sinara-hw/Clocker/README.md

# Clocker
Clock buffer with SMA &amp; MMCX input and 4 SMA &amp; 6 MMCX outputs

## Design Files

Design files (schematics, PCB layouts, BOMs) can be found at [Clocker/Releases](https://github.com/sinara-hw/Clocker/releases).

## Wiki

More information can be found on the [wiki](https://github.com/sinara-hw/Clocker/wiki).
