sinara-hw/Clocker/(list of files, drawings)

Other design files:
Clocker.PrjPcb
Clocker.SchDoc
