sinara-hw/Clocker/(threads)

Thread 1 (2018-06-13):

Clocker: fix grounding

marmeladapk, 2018-06-13:
_From @hartytp on [2018-03-28 23:31](https://github.com/sinara-hw/sinara/issues/537)_

same as Kasli https://github.com/sinara-hw/sinara/issues/499#issuecomment-377071799

hartytp, 2020-05-25:
Really, we should just use a flux-cored balun for the output isolation like in other designs. 1GHz should still be enough bandwidth to transmit a decent square wave output

gkasprow, 2020-05-25:
Good idea. What about TC2-72T+  50 Ohms 10 to 700 MHz RF Transformer ?

hartytp, 2020-05-25:
That seems to be about the fastest that MCL do, so yeah sounds about right...

As this is a major change, it's worth giving other stakeholders (@jordens) a chance to comment before deciding

dnadlinger, 2020-05-25:
Mostly to satisfy my own curiosity: Why go back on the earlier design choice now?

I didn't check how the TC2-72T+ compares to the current choice in terms of insertion loss/bandwidth, but one thing to consider would be to keep enough slew rate to be able to cascade Clockers with little phase noise degradation even with moderate coax losses in between (the ADCLK950 performance starts to degrade below 4 V/ns).

jordens, 2020-05-25:
This would kill (or at least risk) 1 GHz direct drive Urukul applications. Nobody felt the need to populate the balun (transmission line or not) there either. Is there data that says the transmission line transformers are a problem? And do we know that the loss in bandwidth does not represent one?
I don't see the benefit.
#4 would be very helpful here.

hartytp, 2020-05-25:
> Nobody felt the need to populate the balun (transmission line or not) there either.

I don't follow your point here. In the current release of clocker there are TCM2-43X+ baluns on all inputs and outputs.

hartytp, 2020-05-25:
> Is there data that says the transmission line transformers are a problem?

It's very situation dependent but, yes, I've certainly seen cases where measured clock phase noise was significantly higher than expected from data sheets and where the resolution was to add an RF isolation transformer.

@dnadlinger whether that's more of an issue than the decrease in bandwidth in a particular situation is hard to tell without measurements, but I have definitely seen cases where it was. And, given that one of our major use-cases for clocker is sending our time base between labs, I wouldn't be confident saying that it's not an issue without checking.

Running the numbers crudely, if we want `2*pi*f*A=4V/ns` then at 700MHz we need 650mV signal amplitude in the differential signal. The clock buffer puts out 800mV amplitude (again differential), so I agree that we don't have a huge amount of headroom once the various losses are included and we will likely not achieve the IC's specified noise floor with a slower balun. Having said that, I doubt we're achieving it now due to ground loops etc, so it's hard to know whether it would get better or worse.

> This would kill (or at least risk) 1 GHz direct drive Urukul applications.

That's not a use case I've considered. But, yes, if people are actually using clocker at 1GHz then this balun is likely not appropriate.

Anyway, I don't feel too strongly about this other than that we should not be using capacitors for isolation.

gkasprow, 2020-05-25:
What we can do is to make isolation transformer variant default. The output baluns were used only to ramp up the amplitude twice and to have the same rise and fall time. The xECL output stage can only source current. Balun makes the output fully symmetrical. What we can do is to have two assembly variants - one, direct output without a balun, with twice lower amplitude but higher BW (comparing with a balun). Second variant would be with fully isolating transformers, higher amplitude but 700MHz BW

hartytp, 2020-05-25:
If people are worried about slew rates then we should keep the TLT as a variant.

gkasprow, 2020-05-25:
Both balun and transformer have compatible footprints. We can make a variant and populate one or another.

gkasprow, 2020-05-25:
That's not that easy. The footprints are compatible but rotated. I would need to add two more 0R resistors to the assembly variant. I'm not sure if it is worth the effort. I think it's too complex
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

hartytp, 2020-05-25:
Sure, let's just unfloat the grounds and leave it as is then.

gkasprow, 2020-05-25:
@hartytp before, default configuration was 100k biasing resistor and AC-coupling.
Shall I change this? TS plans to produce a large batch of these boards.

jordens, 2020-05-26:
> > Nobody felt the need to populate the balun (transmission line or not) there either.
>
> I don't follow your point here. In the current release of clocker there are TCM2-43X+ baluns on all inputs and outputs.

'There' meaning urukul.

jordens, 2020-05-26:
> It's very situation dependent but, yes, I've certainly seen cases where measured clock phase noise was significantly higher than expected from data sheets and where the resolution was to add an RF isolation transformer.

I'm sure that it can be a problem. And in that situation you do need to sacrifice bandwidth to isolation. I'd add an external dedicated balun there.

gkasprow, 2020-05-26:
so what's the conclusion. DO you want 100k or 0R resistor between GND and SMA ?

jordens, 2020-05-26:
0R in my opinion. We don't do differentially floating sma like that anymore AFAICT. It made things worse on urukul in the cases I looked at. And it is dangerous/extremely annoying/unhelpful w.r.t. ground voltage differentials.

gkasprow, 2020-05-26:
OK, so let's close this issue

dtcallcock, 2020-05-28:
>0R in my opinion. We don't do differentially floating sma like that anymore AFAICT. It made things worse on urukul in the cases I looked at.

The discussion in the wiki should probably be re-written to reflect this new school of thought.

Closed 2020-05-26.

Thread 2 (2018-06-13):

Clocker v1 errata and tests

marmeladapk, 2018-06-13:
_From @gkasprow on [2017-12-12 11:01](https://github.com/sinara-hw/sinara/issues/421)_

Clocker v1 arrived.
There are some minor issues:
- [x] Use the 712RA barrel connector (not the long barrel L712RA). Same footprint. Just shorter barrel.
- [x] voltage setting resistor should be 33k instead of 3.3k
- [x] front panel SMA assignment is wrong - clock input is on bottom, not top. It was in initial project and changes were not transferred to the panel design.
- [x] insulating washers are bigger than in documentation. The SMA port description must be shifted away by 1mm
- [x] SMA connector mechanical models are different than actual connectors. Actual ones do not have a ring around the SMA thread. So I had to install a washer to give a support for insulating washer
- [x] move new supply connector 0.75mm towards the panel
- [x] add insulating washers to BOM
- [x] consider adding an LC filter or ferrite bead between the SMPS and LDO. Maybe add a tantalum cap to damp any LC ringing? Use same inductor that is already used on the SMPS in combination with a large tantalum cap.
- [x] Populate MMCX input.
- [x] Silk + schematic + panel should be "v1.x" not "rev1.x"
- [x] add divider on PGFB pin

Otherwise it works fine.
Today I will ship it to @hartytp

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

marmeladapk, 2018-06-13:
_From @hartytp on [2017-12-12 14:33](https://github.com/sinara-hw/sinara/issues/421#issuecomment-351068322)_

Great, thanks!

marmeladapk, 2018-06-13:
_From @jbqubit on [2017-12-12 14:59](https://github.com/sinara-hw/sinara/issues/421#issuecomment-351076149)_

Looks great!

marmeladapk, 2018-06-13:
_From @hartytp on [2018-02-01 14:15](https://github.com/sinara-hw/sinara/issues/421#issuecomment-362277991)_

Had a look at clocker today. The error on the FP threw me for a while other than that, it looks good...

Source for all measurements is a Wenzel 100MHz oscillator (+13dBm) driving clocker directly via the FP SMA.

marmeladapk, 2018-06-13:
_From @hartytp on [2018-02-01 14:20](https://github.com/sinara-hw/sinara/issues/421#issuecomment-362279369)_

Rise time is something like a few hundred ps ignoring the reflections. The ADCLK itself should provide more like 100ps, but once the balun and the scope BW (4GHz) are taken into account, this is roughly what one expects.

Pk to pk signal is about 800mV. Expect 16.Vpp out of the ADCLK, that's 1.1Vpp into 50R, and 900mV once the 2dB (ish) balun loss at 100MHz is taken into account.

SI looks generally good on the scope. So this all checks out...
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

marmeladapk, 2018-06-13:
_From @hartytp on [2018-02-01 14:26](https://github.com/sinara-hw/sinara/issues/421#issuecomment-362281326)_

Phase noise looks excellent (plots to follow later).
- noise floor at about -145dBc/Hz
  - NB this is not expected to follow the 20*log(f) scaling with the frequency of the carrier.
  - limit to white noise is probably the fact that I'm doing this at 10MHz. dV/dt is: 2xpixAxf= 2xpix(sqrt(2)x1.4V)x100MHz=1V/ns. Looking at figure 12 of the datasheet, we're definitely still in the regime where the jitter is limited by the input slew rate, so this makes sense.

marmeladapk, 2018-06-13:
_From @hartytp on [2018-02-01 14:27](https://github.com/sinara-hw/sinara/issues/421#issuecomment-362281663)_

I did see a few spurs, particularly on the AM spectrum, which look like they come from the SMPS. Probably worth adding an LC filter (or ferrite) between the SMPS and LDO. If we do that, make sure to add a tantalum cap or something to prevent ringing in the LC filter.

marmeladapk, 2018-06-13:
_From @hartytp on [2018-02-01 14:28](https://github.com/sinara-hw/sinara/issues/421#issuecomment-362282053)_

Anyway, great work @gkasprow on another design that worked more or less perfectly on the first attempt! It's a very low priority compared with Sayma/Booster, but at some point I'd like to order some more of these with the bug fixes applied.

marmeladapk, 2018-06-13:
_From @gkasprow on [2018-02-01 14:53](https://github.com/sinara-hw/sinara/issues/421#issuecomment-362289359)_

I have a few pieces still in my lab. I will test them in a few days.

marmeladapk, 2018-06-13:
_From @hartytp on [2018-02-01 15:08](https://github.com/sinara-hw/sinara/issues/421#issuecomment-362293989)_

@gkasprow There are no more tests that I want to see done; as far as I'm concerned this board works and nothing else is needed.

I'd prefer to buy v1.1 boards with the fixes applied (e.g. a new front panel!).

marmeladapk, 2018-06-13:
_From @gkasprow on [2018-02-01 15:14](https://github.com/sinara-hw/sinara/issues/421#issuecomment-362295958)_

new front panel is already attached to all shipped boards. We can ship you correct one.
All the fixes are already applied to existing boards, so the only difference would be this ferrite bead.
You wanted 4 clocker prototypes, @jbqubit  wanted 2, we did 10, so there are still 4 free ...
Actually, I can mount these ferrite beads on existing 4 pcs so they won't differ from v1.1.

marmeladapk, 2018-06-13:
_From @hartytp on [2018-02-01 15:15](https://github.com/sinara-hw/sinara/issues/421#issuecomment-362296358)_

@gkasprow okay, np. If you apply the fixes above then that's fine by me.

marmeladapk, 2018-06-13:
_From @gkasprow on [2018-02-01 15:41](https://github.com/sinara-hw/sinara/issues/421#issuecomment-362305050)_

Here is a fix:
100R/1A ferrite bead + 6.8uF tantalium cap
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

marmeladapk, 2018-06-13:
_From @hartytp on [2018-02-01 15:43](https://github.com/sinara-hw/sinara/issues/421#issuecomment-362305765)_

> 100R/1A ferrite bead + 6.8uF tantalium cap

What P/N?

marmeladapk, 2018-06-13:
_From @gkasprow on [2018-02-01 16:18](https://github.com/sinara-hw/sinara/issues/421#issuecomment-362317510)_

  well, I took one from a drawer. It is 100R@100MHz, 150mOhm, 1A ferrite bead. i.e. [this one](http://pl.farnell.com/tdk/mpz1608d101bt/ferrite-bead-100r-1a-0603/dp/2800770)
6.8uF/10V SMDA, ESR is roughly 3R, one can use [this](http://pl.farnell.com/avx/taja685k010rnj/cap-tant-6-8uf-10v-case-a/dp/2283842?st=6.8uF%20SMDA%2010V)

marmeladapk, 2018-06-13:
_From @gkasprow on [2018-02-01 16:18](https://github.com/sinara-hw/sinara/issues/421#issuecomment-362317731)_

I modified and tested remaining boards

marmeladapk, 2018-06-13:
_From @hartytp on [2018-02-01 16:19](https://github.com/sinara-hw/sinara/issues/421#issuecomment-362318156)_

That won't do much for frequencies <=100kHz will it? The cap ESR is comparable to the bead's impedance isn't it? At that frequency, the FB is just a small inductor IIRC.

marmeladapk, 2018-06-13:
_From @gkasprow on [2018-02-01 16:22](https://github.com/sinara-hw/sinara/issues/421#issuecomment-362318882)_

The tantalium cap is just to lower the Q of the LC circuit. There is 10uF cap at the LDO input.

marmeladapk, 2018-06-13:
_From @gkasprow on [2018-02-01 16:22](https://github.com/sinara-hw/sinara/issues/421#issuecomment-362318973)_

edit 4.7uF ceramic cap

marmeladapk, 2018-06-13:
_From @hartytp on [2018-02-01 16:23](https://github.com/sinara-hw/sinara/issues/421#issuecomment-362319356)_

Still not convinced that's enough. At 100kHz the 4.7uF cap is about 0.3Ohm. Hard to tell from the FB datasheet, but the impedance at 100kHz looks <1Ohm there as well.

marmeladapk, 2018-06-13:
_From @gkasprow on [2018-02-01 16:24](https://github.com/sinara-hw/sinara/issues/421#issuecomment-362319743)_

what we want to achieve is to improve LDO PSRR at higher frequency. Isn't LDO performing good enough at 100kHz? I can place small inductor there, let's say 10uH

marmeladapk, 2018-06-13:
_From @hartytp on [2018-02-01 16:26](https://github.com/sinara-hw/sinara/issues/421#issuecomment-362320391)_

Most of the noise I saw on the output was below 1MHz. So, yes, an inductor and tantalum would probably be the best solution. Let's use the same inductor we already have on the SMSP to avoid introducing an additional BOM line.

marmeladapk, 2018-06-13:
_From @gkasprow on [2018-02-01 16:47](https://github.com/sinara-hw/sinara/issues/421#issuecomment-362327094)_

I used 6.8uH 2.2A inductor I have in lab:
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

marmeladapk, 2018-06-13:
_From @hartytp on [2018-02-01 16:54](https://github.com/sinara-hw/sinara/issues/421#issuecomment-362329692)_

Nice, that should do it.

marmeladapk, 2018-06-13:
_From @hartytp on [2018-02-01 17:16](https://github.com/sinara-hw/sinara/issues/421#issuecomment-362337338)_

Tried increasing the SMSPs output voltage to 4V to improve the PSRR of the LDO. Didn't seem to make any difference...

marmeladapk, 2018-06-13:
_From @jbqubit on [2018-02-02 16:40](https://github.com/sinara-hw/sinara/issues/421#issuecomment-362637548)_

@hartytp Will be interested in seeing your phase noise plot. Please also post that PN for your reference oscillator (or give part number). Do you have a scope that generates eye diagrams?

marmeladapk, 2018-06-13:
_From @hartytp on [2018-02-02 18:35](https://github.com/sinara-hw/sinara/issues/421#issuecomment-362667794)_

Plots look essentially the same as the ones I posted in the issue about the LTC6957 (or whatever the PN is); they're basically what the ADCLK948 datasheet gives. But, yes, I'll post them when I have time.

Will post the oscillator PN. FWIW, we always measure and plot the phase noise of the reference at the same time. That shows the overall noise floor of the measurement.

Eye diagrams aren't useful in this context and any measurement would just be the noise floor of the scope. The phase noise spectrum has everything you need.

marmeladapk, 2018-06-13:
_From @hartytp on [2018-02-02 18:35](https://github.com/sinara-hw/sinara/issues/421#issuecomment-362668003)_

@gkasprow Shall we make the tantalum after the inductor 100uF (assuming that's cheap and readily available in an appropriate package) to really kill the SMPS crud in the 10kHz regime?

marmeladapk, 2018-06-13:
_From @jordens on [2018-02-03 14:47](https://github.com/sinara-hw/sinara/issues/421#issuecomment-362816702)_

Could you have a look at the following when you get time?

* It would be interesting to get a number for the isolation of the clock mux. With one or both inputs being sinusoidal.
* Input and outputs powers.

marmeladapk, 2018-06-13:
_From @hartytp on [2018-02-03 16:48](https://github.com/sinara-hw/sinara/issues/421#issuecomment-362832391)_

> It would be interesting to get a number for the isolation of the clock mux. With one or both inputs being sinusoidal.

Sure. Is 100MHz & 101MHz both + 10dBm sine okay for you? Will probably wait until the MMCX cables I have on order arrive, so may be a week or two.

FWIW though:
- I'd be very surprised if I don't just measure the data sheet value for the ADCLK
- My guess is that users won't apply signals to both inputs very often. This mux isn't remotely controllable so one has to remove if from the rack and manually flip a switch -- although, if people anticipate wanting to do that then we could easily hook the mux control pin to the EEM as well (components can be DNP by default).

> Input

You mean phase noise versus input power? I'm planning to look at 100MHz +0dBm at some point.

> output power

Measured already (see above). It's an 800mVpp square wave into a 50Ohm load (as expected from the mux specified output power and the balun losses).

marmeladapk, 2018-06-13:
_From @jordens on [2018-02-03 18:59](https://github.com/sinara-hw/sinara/issues/421#issuecomment-362845050)_

What is the "datasheet value"? It's unclear (to me at least) what that 90 fs rms value means. I'd expect that to depend dramatically on at least signal slew rate.
ACK the rest. I.e. 5 dBm output.
Just out of curiosity: how much power is in the even harmonics?

marmeladapk, 2018-06-13:
_From @hartytp on [2018-02-03 19:18](https://github.com/sinara-hw/sinara/issues/421#issuecomment-362846462)_

> What is the "datasheet value"? It's unclear (to me at least) what that 90 fs rms value means. I'd expect that to depend dramatically on at least signal slew rate.

ACK, I thought it was better specified than that, but I may be remembering a different datasheet. Will measure once my cables arrive.

> Just out of curiosity: how much power is in the even harmonics?

Will do.

marmeladapk, 2018-06-13:
_From @jbqubit on [2018-02-05 16:25](https://github.com/sinara-hw/sinara/issues/421#issuecomment-363137027)_

As a reference for a clock distribution amp see [SDI HPDA-100RM](http://www.spectradynamics.com/products/hpda-100rm-high-performance-distribution-amplifier-80-20mhz/).

marmeladapk, 2018-06-13:
_From @hartytp on [2018-02-05 16:30](https://github.com/sinara-hw/sinara/issues/421#issuecomment-363138786)_

NB about that kind of thing:
- They don't perform sine-square conversion, which is usually where a lot of the noise comes from for lower frequency references. i.e. if you clock a PLL/DDS off the output from that at 100MHz then don't expect the performance to be as good as the datasheet value.
- IIRC (conversations with the manufacturer) the propagation-delay temp co is about 1ps/K compared with 0.1ps/K for the ADCLK, so AFAICT (not characterised carefully) if you really care about phase stability the ADCLK is the way to go.
- AFAICT, the noise from the ADCLK is low enough to not be a limit in any of the applications we have in mind (see the phase noise models Weida's posted).

That aside, yes, those are very nice buffer amps...

marmeladapk, 2018-06-13:
_From @gkasprow on [2018-03-05 23:56](https://github.com/sinara-hw/sinara/issues/421#issuecomment-370610524)_

@hartytp I just realised that we have already good LC filter after the buck converter. The converter has embedded inductor. So at its output there is already 6.8uH inductor + 22uF tantalium + 22uF ceramic and then LDO.
I had some brain fade and didn't realize this :D

marmeladapk, 2018-06-13:
_From @hartytp on [2018-03-06 00:02](https://github.com/sinara-hw/sinara/issues/421#issuecomment-370611923)_

@gkasprow ack. In that case, we can leave it as is.

Before I forget, can you send me another two boards with the other fixes applied, please? (Very low priority).

marmeladapk, 2018-06-13:
_From @gkasprow on [2018-03-06 00:04](https://github.com/sinara-hw/sinara/issues/421#issuecomment-370612432)_

I handled them to Technosysem some time ago...

marmeladapk, 2018-06-13:
_From @hartytp on [2018-03-06 00:06](https://github.com/sinara-hw/sinara/issues/421#issuecomment-370612812)_

Okay, so I order from them? Will they apply the fixes above?

marmeladapk, 2018-06-13:
_From @gkasprow on [2018-03-06 10:12](https://github.com/sinara-hw/sinara/issues/421#issuecomment-370731714)_

yes

Closed 2020-05-25.

Thread 4 (2018-08-08):

residual phase-noise graphs/datasheet?

aewallin, 2018-08-08:
I would be interested in the residual phase-noise performance of the distribution amplifier at various frequencies.

In particular for 10 MHz distribution I and others have published a few comparison-graphs:
http://www.anderswallin.net/wp-content/uploads/2016/09/fda_2016-09-12_PN.png
https://www.febo.com/pages/amplifier_phase_noise/
It would be interesting to see where the Clocker fits in these graphs.
thanks!
Anders W

hartytp, 2020-05-25:
Out of curiosity, did anyone ever get around to measuring this?

VladSchkolnik, 2022-11-10:
Hi,

I finally found dome time to measure the clockers residual phase and AM noise. As a reference I used a 100MHz Wenzel Quartz, that is phaselocked to a 10MHz Wenzel  blue top.

Blue trace: 100MHz versus  the same 100MHz as a reference measurement.

Pink trace: 100MHz vs Clockers 100 MHz Output (residual noise from clocker)

PN:

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

AM:

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

Our measurement shows no AM zu PM conversion.

and the MDEV:

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

The Performance is en par with other high performance distribution amps. The higher noise below 10Hz is mostly due to temperature effects (Roberts suggestion that I agree with)

Is there any interest to repeat the measurement with temperature logging or other frequencies?

hartytp, 2022-11-10:
Lovely data, thanks for posting! Looks pretty darn close to the datasheet as well

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

Closed 2023-12-06.

Thread 5 (2018-08-18):

Clocker: fix grounding

gkasprow, 2018-08-18:
_From @hartytp on March 28, 2018 23:31_

same as Kasli https://github.com/sinara-hw/sinara/issues/499#issuecomment-377071799

_Copied from original issue: sinara-hw/sinara#537_

gkasprow, 2018-08-18:
_From @marmeladapk on June 13, 2018 15:0_

_Migrated to sinara-hw/Clocker#1_

Closed 2018-08-21.

Thread 6 (2018-08-18):

Clocker v1 errata and tests

gkasprow, 2018-08-18:
_From @gkasprow on December 12, 2017 11:1_

Clocker v1 arrived.
There are some minor issues:
- [ ] Use the 712RA barrel connector (not the long barrel L712RA). Same footprint. Just shorter barrel.
- [x] voltage setting resistor should be 33k instead of 3.3k
- [x] front panel SMA assignment is wrong - clock input is on bottom, not top. It was in initial project and changes were not transferred to the panel design.
- [ ] insulating washers are bigger than in documentation. The SMA port description must be shifted away by 1mm
- [ ] SMA connector mechanical models are different than actual connectors. Actual ones do not have a ring around the SMA thread. So I had to install a washer to give a support for insulating washer
- [ ] move new supply connector 0.75mm towards the panel
- [x] add insulating washers to BOM
- [ ] consider adding an LC filter or ferrite bead between the SMPS and LDO. Maybe add a tantalum cap to damp any LC ringing? Use same inductor that is already used on the SMPS in combination with a large tantalum cap.
- [ ] Populate MMCX input.
- [ ] Silk + schematic + panel should be "v1.x" not "rev1.x"

Otherwise it works fine.
Today I will ship it to @hartytp

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

_Copied from original issue: sinara-hw/sinara#421_

gkasprow, 2018-08-18:
_From @hartytp on December 12, 2017 14:33_

Great, thanks!

gkasprow, 2018-08-18:
_From @jbqubit on December 12, 2017 14:59_

Looks great!

gkasprow, 2018-08-18:
_From @hartytp on February 1, 2018 14:15_

Had a look at clocker today. The error on the FP threw me for a while other than that, it looks good...

Source for all measurements is a Wenzel 100MHz oscillator (+13dBm) driving clocker directly via the FP SMA.

gkasprow, 2018-08-18:
_From @hartytp on February 1, 2018 14:20_

Rise time is something like a few hundred ps ignoring the reflections. The ADCLK itself should provide more like 100ps, but once the balun and the scope BW (4GHz) are taken into account, this is roughly what one expects.

Pk to pk signal is about 800mV. Expect 16.Vpp out of the ADCLK, that's 1.1Vpp into 50R, and 900mV once the 2dB (ish) balun loss at 100MHz is taken into account.

SI looks generally good on the scope. So this all checks out...
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

gkasprow, 2018-08-18:
_From @hartytp on February 1, 2018 14:26_

Phase noise looks excellent (plots to follow later).
- noise floor at about -145dBc/Hz
  - NB this is not expected to follow the 20*log(f) scaling with the frequency of the carrier.
  - limit to white noise is probably the fact that I'm doing this at 10MHz. dV/dt is: 2xpixAxf= 2xpix(sqrt(2)x1.4V)x100MHz=1V/ns. Looking at figure 12 of the datasheet, we're definitely still in the regime where the jitter is limited by the input slew rate, so this makes sense.

gkasprow, 2018-08-18:
_From @hartytp on February 1, 2018 14:27_

I did see a few spurs, particularly on the AM spectrum, which look like they come from the SMPS. Probably worth adding an LC filter (or ferrite) between the SMPS and LDO. If we do that, make sure to add a tantalum cap or something to prevent ringing in the LC filter.

gkasprow, 2018-08-18:
_From @hartytp on February 1, 2018 14:28_

Anyway, great work @gkasprow on another design that worked more or less perfectly on the first attempt! It's a very low priority compared with Sayma/Booster, but at some point I'd like to order some more of these with the bug fixes applied.

gkasprow, 2018-08-18:
I have a few pieces still in my lab. I will test them in a few days.

gkasprow, 2018-08-18:
_From @hartytp on February 1, 2018 15:8_

@gkasprow There are no more tests that I want to see done; as far as I'm concerned this board works and nothing else is needed.

I'd prefer to buy v1.1 boards with the fixes applied (e.g. a new front panel!).

gkasprow, 2018-08-18:
new front panel is already attached to all shipped boards. We can ship you correct one.
All the fixes are already applied to existing boards, so the only difference would be this ferrite bead.
You wanted 4 clocker prototypes, @jbqubit  wanted 2, we did 10, so there are still 4 free ...
Actually, I can mount these ferrite beads on existing 4 pcs so they won't differ from v1.1.

gkasprow, 2018-08-18:
_From @hartytp on February 1, 2018 15:15_

@gkasprow okay, np. If you apply the fixes above then that's fine by me.

gkasprow, 2018-08-18:
Here is a fix:
100R/1A ferrite bead + 6.8uF tantalium cap
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

gkasprow, 2018-08-18:
_From @hartytp on February 1, 2018 15:43_

> 100R/1A ferrite bead + 6.8uF tantalium cap

What P/N?

gkasprow, 2018-08-18:
well, I took one from a drawer. It is 100R@100MHz, 150mOhm, 1A ferrite bead. i.e. [this one](http://pl.farnell.com/tdk/mpz1608d101bt/ferrite-bead-100r-1a-0603/dp/2800770)
6.8uF/10V SMDA, ESR is roughly 3R, one can use [this](http://pl.farnell.com/avx/taja685k010rnj/cap-tant-6-8uf-10v-case-a/dp/2283842?st=6.8uF%20SMDA%2010V)

gkasprow, 2018-08-18:
I modified and tested remaining boards

gkasprow, 2018-08-18:
_From @hartytp on February 1, 2018 16:19_

That won't do much for frequencies <=100kHz will it? The cap ESR is comparable to the bead's impedance isn't it? At that frequency, the FB is just a small inductor IIRC.

gkasprow, 2018-08-18:
The tantalium cap is just to lower the Q of the LC circuit. There is 10uF cap at the LDO input.

gkasprow, 2018-08-18:
edit 4.7uF ceramic cap

gkasprow, 2018-08-18:
_From @hartytp on February 1, 2018 16:23_

Still not convinced that's enough. At 100kHz the 4.7uF cap is about 0.3Ohm. Hard to tell from the FB datasheet, but the impedance at 100kHz looks <1Ohm there as well.

gkasprow, 2018-08-18:
what we want to achieve is to improve LDO PSRR at higher frequency. Isn't LDO performing good enough at 100kHz? I can place small inductor there, let's say 10uH

gkasprow, 2018-08-18:
_From @hartytp on February 1, 2018 16:26_

Most of the noise I saw on the output was below 1MHz. So, yes, an inductor and tantalum would probably be the best solution. Let's use the same inductor we already have on the SMSP to avoid introducing an additional BOM line.

gkasprow, 2018-08-18:
I used 6.8uH 2.2A inductor I have in lab:
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

gkasprow, 2018-08-18:
_From @hartytp on February 1, 2018 16:54_

Nice, that should do it.

gkasprow, 2018-08-18:
_From @hartytp on February 1, 2018 17:16_

Tried increasing the SMSPs output voltage to 4V to improve the PSRR of the LDO. Didn't seem to make any difference...

gkasprow, 2018-08-18:
_From @jbqubit on February 2, 2018 16:40_

@hartytp Will be interested in seeing your phase noise plot. Please also post that PN for your reference oscillator (or give part number). Do you have a scope that generates eye diagrams?

gkasprow, 2018-08-18:
_From @hartytp on February 2, 2018 18:35_

Plots look essentially the same as the ones I posted in the issue about the LTC6957 (or whatever the PN is); they're basically what the ADCLK948 datasheet gives. But, yes, I'll post them when I have time.

Will post the oscillator PN. FWIW, we always measure and plot the phase noise of the reference at the same time. That shows the overall noise floor of the measurement.

Eye diagrams aren't useful in this context and any measurement would just be the noise floor of the scope. The phase noise spectrum has everything you need.

gkasprow, 2018-08-18:
_From @hartytp on February 2, 2018 18:35_

@gkasprow Shall we make the tantalum after the inductor 100uF (assuming that's cheap and readily available in an appropriate package) to really kill the SMPS crud in the 10kHz regime?

gkasprow, 2018-08-18:
_From @jordens on February 3, 2018 14:47_

Could you have a look at the following when you get time?

* It would be interesting to get a number for the isolation of the clock mux. With one or both inputs being sinusoidal.
* Input and outputs powers.

gkasprow, 2018-08-18:
_From @hartytp on February 3, 2018 16:48_

> It would be interesting to get a number for the isolation of the clock mux. With one or both inputs being sinusoidal.

Sure. Is 100MHz & 101MHz both + 10dBm sine okay for you? Will probably wait until the MMCX cables I have on order arrive, so may be a week or two.

FWIW though:
- I'd be very surprised if I don't just measure the data sheet value for the ADCLK
- My guess is that users won't apply signals to both inputs very often. This mux isn't remotely controllable so one has to remove if from the rack and manually flip a switch -- although, if people anticipate wanting to do that then we could easily hook the mux control pin to the EEM as well (components can be DNP by default).

> Input

You mean phase noise versus input power? I'm planning to look at 100MHz +0dBm at some point.

> output power

Measured already (see above). It's an 800mVpp square wave into a 50Ohm load (as expected from the mux specified output power and the balun losses).

gkasprow, 2018-08-18:
_From @jordens on February 3, 2018 18:59_

What is the "datasheet value"? It's unclear (to me at least) what that 90 fs rms value means. I'd expect that to depend dramatically on at least signal slew rate.
ACK the rest. I.e. 5 dBm output.
Just out of curiosity: how much power is in the even harmonics?

gkasprow, 2018-08-18:
_From @hartytp on February 3, 2018 19:18_

> What is the "datasheet value"? It's unclear (to me at least) what that 90 fs rms value means. I'd expect that to depend dramatically on at least signal slew rate.

ACK, I thought it was better specified than that, but I may be remembering a different datasheet. Will measure once my cables arrive.

> Just out of curiosity: how much power is in the even harmonics?

Will do.

gkasprow, 2018-08-18:
_From @jbqubit on February 5, 2018 16:25_

As a reference for a clock distribution amp see [SDI HPDA-100RM](http://www.spectradynamics.com/products/hpda-100rm-high-performance-distribution-amplifier-80-20mhz/).

Closed 2018-08-21.

Thread 7 (2018-11-13):

power LED slow turn on

jordens, 2018-11-13:
Takes about 2 seconds to light up fully. Just irritating.

gkasprow, 2018-11-13:
It's LDO filter capacitor (C101). LED can be connected before the LDO.

hartytp, 2019-12-20:
- [ ] Use LT304x fast start

gkasprow, 2020-05-25:
added 12k : 1k3 divider. Existing resistors were used to not add positions to BOM
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

Closed 2020-05-25.

Thread 9 (2020-03-19):

add diodes to both power inputs

sbourdeauducq, 2020-03-19:
Avoids powering Kasli/EEMs through the EEM cable, or applying power in reverse to power supply adapters.
Similar issue as https://github.com/sinara-hw/Stabilizer/issues/72

gkasprow, 2020-05-25:
added 2 diodes
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

Closed 2020-05-25.

Thread 11 (2023-07-13):

Obsolete switch

filipswit, 2023-07-13:
1-1437575-4 and SSA-12 are obsolete. It could be replaced by EG1218.

Closed 2023-10-17.

Thread 12 (2023-09-07):

reference power

jbqubit, 2023-09-07:
Clocker requires a reference clock. We observe that when 100 MHz 0 dBm is applied to the SMA input the output contains high-amplitude spurious features. Increasing the input amplitude to 12 dBm resolves the problem.

# Observations

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
(above) 100 MHz at 0 dBm from a clean RF source (Rigol DG4162).

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
(above) Output of Clocker with 0 dBm applied to SMA input.

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
(above) Output of Clocker with +12 dBm applied to SMA input.

# Comment
The clock distribution chip is ADCLK950BCPZ ([link](https://www.analog.com/en/products/adclk950.html)). The minimum (recommended) differential clock amplitude is 0.4 Vpp (1.7 Vpp).

In [10]: Vpp = 0.4; P=Vpp**2/(8*50); 10*np.log10(P/0.001)
Out[10]: -3.9794000867203754

In [11]: Vpp = 1.7; P=Vpp**2/(8*50); 10*np.log10(P/0.001)
Out[11]: 8.588378514285854

Including conversion from single-ended to differential I'm surprised that this requires 12 dBm. Anyway, I've updated the wiki with a recommended input power.

gkasprow, 2023-09-07:
A low amplitude input signal makes the circuit more susceptible to power supply noise.
The DC/DC converter runs at about 1MHz. You observe spurious produts at about 450kHz and 900kHz which suggests other sources. Moreover, we have LC filter + LDO, it's PSRR is 80dB for 1MHz.
So, maybe your setup picks these 450kHz from a ground loop or so?

jbqubit, 2023-09-08:
I don't think it's a ground loop since many of the the close-to-carrier spurs are reduced by 30 dB with greater clock power. I make this Issue to give others a heads up and to punctuate the addition of an input power spec to the clock input on the wiki.

Closed 2023-09-07.

Thread 14 (2023-12-06):

12V barrel  connector shorts out filter to chassis

jordens, 2023-12-06:
Add isolation sleeve and washer, larger panel hole, as for Kasli/Kasli-SoC etc.

Closed 2025-02-11.
