sinara-hw/Clocker/(commit log)

2023-10-17 Clocker v1.2 WIP
    - added rear power connector
    - added no-erc markers on nc pins
    - Updated copyright year
    - Moved and swapped around MMCX outputs
    - Moved LT3045 down on PCB
    - Preparations for 1:1 and 1:4 baluns
    [Clocker.PrjPcb, Clocker.SchDoc]
2023-10-17 v1.2 RC1
    - changed switch closes #11
    - added impedance profiles
    - cleaned up xsignals and high-speed rules
    - added rule to ignore collision with panel and washers
    - cleaned up schematics
    - updated license
    - added license notice on the PCB
    - added SMA_6dBm variant with 120 Ohm resistors on LVPECL outputs
    - updated outputjob
    - added gitignore
    Created using Altium 23.7.1.
    [Clocker.PrjPcb, Clocker.SchDoc]
2023-12-31 added missing step file of switch
2025-02-11 v1.3 - EEPROM added #16 - MOLEX 39-30-0040 for rear 12V #15 - Front power connector moved #14 - Position of MMCX connetors changed to have all of them in one row (easier cable routing) - Board is lon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
    [Clocker.PrjPcb, Clocker.SchDoc]
